gtetil/flame-detect-pcb/flame-detect-pcb.kicad_pcb

## KiCad design flame-detect-pcb.kicad_pcb (2018-03-28)

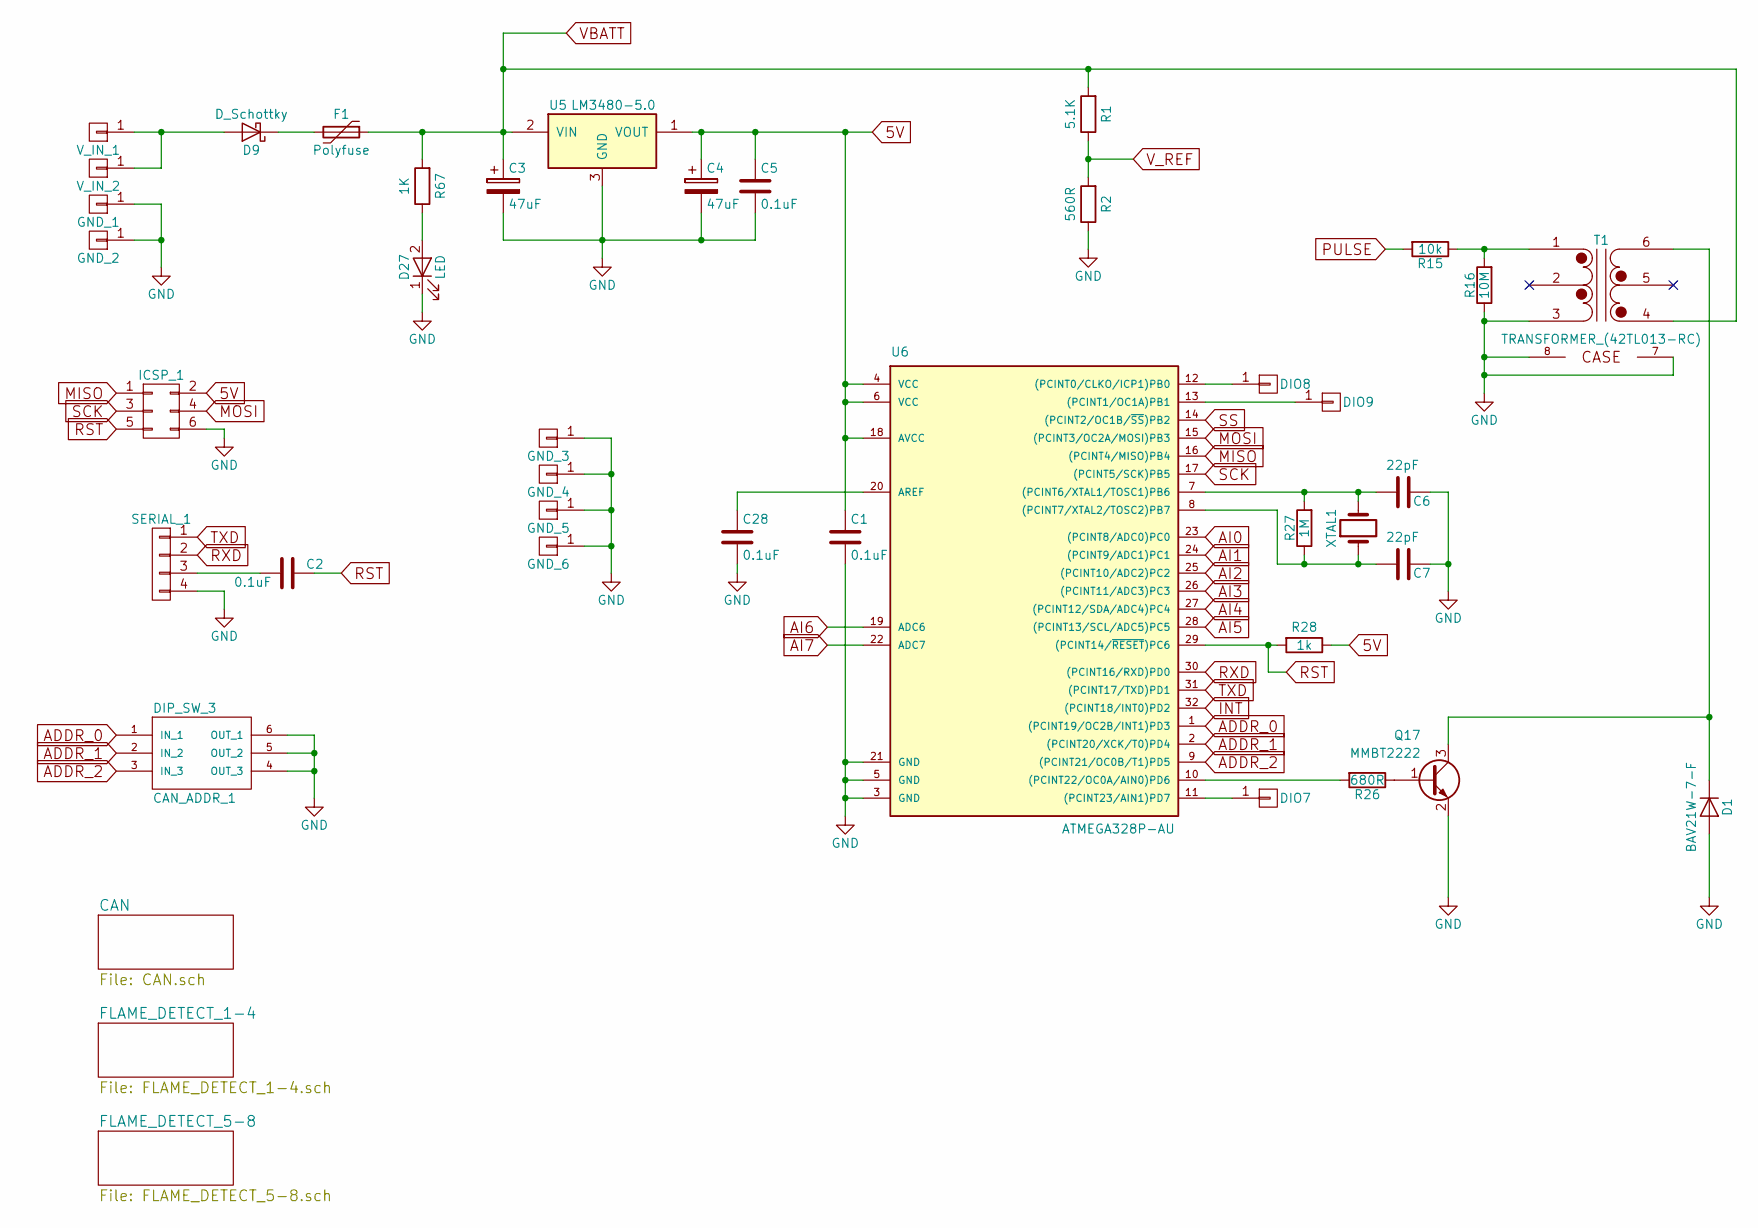
[picture p1: schematic flame-detect-pcb.sch]

Parts:
C1, C2, C5, C28: 0.1uF; C_0805
C3, C4: 47uF; CP_Elec_6.3x5.3
C6, C7: 22pF; C_0805
CAN_ADDR_1: DIP_SW_3; SW_DIP_x3_W8.61mm_Slide_LowProfile
D1: BAV21W-7-F; D_SOD-123
D9: D_Schottky; DO-214AB
D27: LED; LED_1206
DIO7, DIO8, DIO9: CONN_01X01; SPARE_THROUGH_HOLE
F1: Polyfuse; R_1812
GND_1, GND_2: CONN_01X01; KEYSTONE_SPADE_TERM_(1287)
GND_3, GND_4, GND_5, GND_6: CONN_01X01; PEM_STANDOFF_THRU_(SMTSOB-116-12ET)
ICSP_1: CONN_02X03; Pin_Header_Straight_2x03_Pitch2.54mm_SMD
Q17: MMBT2222; SOT-23
R1: 5.1K; R_0805
R2: 560R; R_0805
R15: 10k; R_0805
R16: 10M; R_0805
R26: 680R; R_0805
R27: 1M; R_0805
R28: 1k; R_0805
R67: 1K; R_0805
SERIAL_1: CONN_01X04; Pin_Header_Straight_1x04_Pitch2.54mm_SMD_Pin1Right
T1: TRANSFORMER_(42TL013-RC)
U5: LM3480-5.0; SOT-23
U6: ATMEGA328P-AU; TQFP-32_7x7mm_Pitch0.8mm
V_IN_1, V_IN_2: CONN_01X01; KEYSTONE_SPADE_TERM_(1287)
XTAL1: Crystal; Crystal_SMD_HC49-SD

Connections:
5V: C1.1, C4.1, C5.1, ICSP_1.2, R28.1, U5.1 (VOUT), U6.4 (VCC), U6.6 (VCC), U6.18 (AVCC); also elsewhere on the board
ADDR_0: CAN_ADDR_1.1 (IN_1), U6.1 ((PCINT19/OC2B/INT1)PD3)
ADDR_1: CAN_ADDR_1.2 (IN_2), U6.2 ((PCINT20/XCK/T0)PD4)
ADDR_2: CAN_ADDR_1.3 (IN_3), U6.9 ((PCINT21/OC0B/T1)PD5)
AI0: U6.23 ((PCINT8/ADC0)PC0); also elsewhere on the board
AI1: U6.24 ((PCINT9/ADC1)PC1); also elsewhere on the board
AI2: U6.25 ((PCINT10/ADC2)PC2); also elsewhere on the board
AI3: U6.26 ((PCINT11/ADC3)PC3); also elsewhere on the board
AI4: U6.27 ((PCINT12/SDA/ADC4)PC4); also elsewhere on the board
AI5: U6.28 ((PCINT13/SCL/ADC5)PC5); also elsewhere on the board
AI6: U6.19 (ADC6); also elsewhere on the board
AI7: U6.22 (ADC7); also elsewhere on the board
GND: C1.2, C3.2, C4.2, C5.2, C6.1, C7.1, C28.2, CAN_ADDR_1.4 (OUT_3), CAN_ADDR_1.5 (OUT_2), CAN_ADDR_1.6 (OUT_1), D1.2 (A), D27.1 (K), GND_1.1, GND_2.1, GND_3.1, GND_4.1, GND_5.1, GND_6.1, ICSP_1.6, Q17.2 (E), R2.1, R16.1, SERIAL_1.4, T1.3 (PR2), T1.7 (GND), T1.8 (GND), U5.3 (GND), U6.3 (GND), U6.5 (GND), U6.21 (GND); also elsewhere on the board
INT: U6.32 ((PCINT18/INT0)PD2); also elsewhere on the board
MISO: ICSP_1.1, U6.16 ((PCINT4/MISO)PB4); also elsewhere on the board
MOSI: ICSP_1.4, U6.15 ((PCINT3/OC2A/MOSI)PB3); also elsewhere on the board
unnamed: C2.2, SERIAL_1.3
unnamed: C6.2, R27.2, U6.7 ((PCINT6/XTAL1/TOSC1)PB6), XTAL1.2
unnamed: C7.2, R27.1, U6.8 ((PCINT7/XTAL2/TOSC2)PB7), XTAL1.1
unnamed: C28.1, U6.20 (AREF)
unnamed: D1.1 (K), Q17.3 (C), T1.6 (S3)
unnamed: D9.1 (K), F1.2
unnamed: D9.2 (A), V_IN_1.1, V_IN_2.1
unnamed: D27.2 (A), R67.1
unnamed: DIO7.1, U6.11 ((PCINT23/AIN1)PD7)
unnamed: DIO8.1, U6.12 ((PCINT0/CLKO/ICP1)PB0)
unnamed: DIO9.1, U6.13 ((PCINT1/OC1A)PB1)
unnamed: Q17.1 (B), R26.1
unnamed: R15.1, R16.2, T1.1 (PR1)
unnamed: R26.2, U6.10 ((PCINT22/OC0A/AIN0)PD6)
PULSE: R15.2; also elsewhere on the board
RST: C2.1, ICSP_1.5, R28.2, U6.29 ((PCINT14/~RESET~)PC6)
RXD: SERIAL_1.2, U6.30 ((PCINT16/RXD)PD0)
SCK: ICSP_1.3, U6.17 ((PCINT5/SCK)PB5); also elsewhere on the board
SS: U6.14 ((PCINT2/OC1B/~SS~)PB2); also elsewhere on the board
TXD: SERIAL_1.1, U6.31 ((PCINT17/TXD)PD1)
VBATT: C3.1, F1.1, R1.2, R67.2, T1.4 (S1), U5.2 (VIN); also elsewhere on the board
V_REF: R1.1, R2.2; also elsewhere on the board

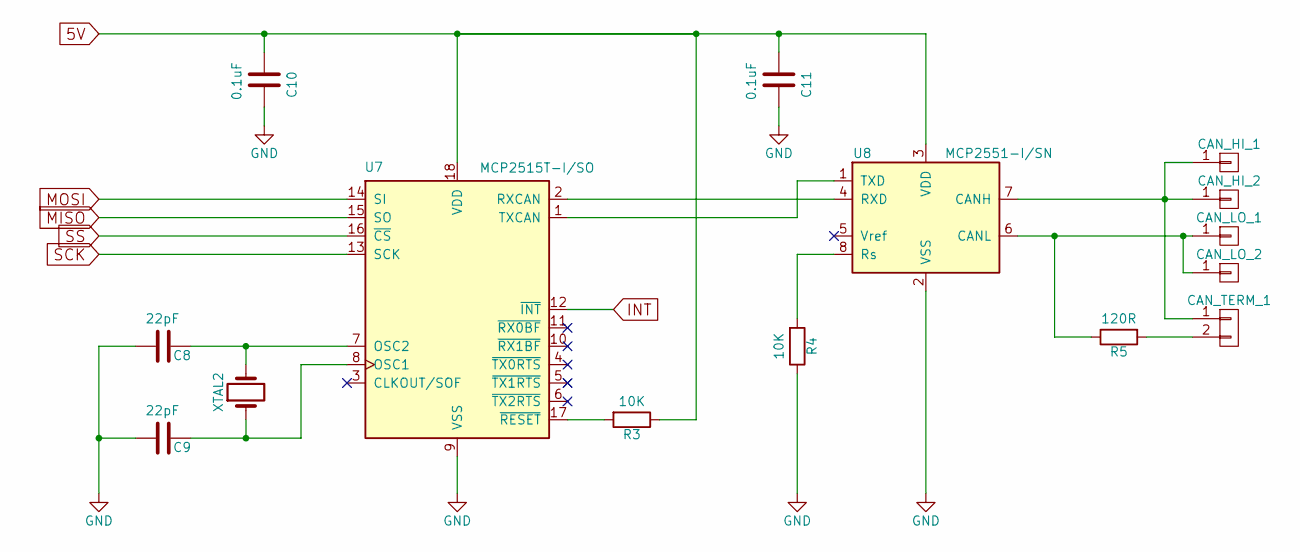
[picture p2: schematic CAN.sch]

Parts:
C8, C9: 22pF; C_0805
C10, C11: 0.1uF; C_0805
CAN_HI_1, CAN_HI_2: CONN_01X01; KEYSTONE_SPADE_TERM_(1287)
CAN_LO_1, CAN_LO_2: CONN_01X01; KEYSTONE_SPADE_TERM_(1287)
CAN_TERM_1: CONN_01X02; Pin_Header_Straight_1x02_Pitch2.54mm_SMD_Pin1Right
R3, R4: 10K; R_0805
R5: 120R; R_0805
U7: MCP2515T-I/SO; SOIC-18W_7.5x11.6mm_Pitch1.27mm
U8: MCP2551-I/SN; SOIC-8_3.9x4.9mm_Pitch1.27mm
XTAL2: Crystal; Crystal_SMD_HC49-SD

Connections:
5V: C10.2, C11.2, R3.1, U7.18 (VDD), U8.3 (VDD); also elsewhere on the board
GND: C8.2, C9.2, C10.1, C11.1, R4.1, U7.9 (VSS), U8.2 (VSS); also elsewhere on the board
INT: U7.12 (~INT); also elsewhere on the board
MISO: U7.15 (SO); also elsewhere on the board
MOSI: U7.14 (SI); also elsewhere on the board
unnamed: C8.1, U7.7 (OSC2), XTAL2.2
unnamed: C9.1, U7.8 (OSC1), XTAL2.1
unnamed: CAN_HI_1.1, CAN_HI_2.1, CAN_TERM_1.1, U8.7 (CANH)
unnamed: CAN_LO_1.1, CAN_LO_2.1, R5.1, U8.6 (CANL)
unnamed: CAN_TERM_1.2, R5.2
unnamed: R3.2, U7.17 (~RESET)
unnamed: R4.2, U8.8 (Rs)
unnamed: U7.1 (TXCAN), U8.1 (TXD)
unnamed: U7.2 (RXCAN), U8.4 (RXD)
SCK: U7.13 (SCK); also elsewhere on the board
SS: U7.16 (~CS); also elsewhere on the board

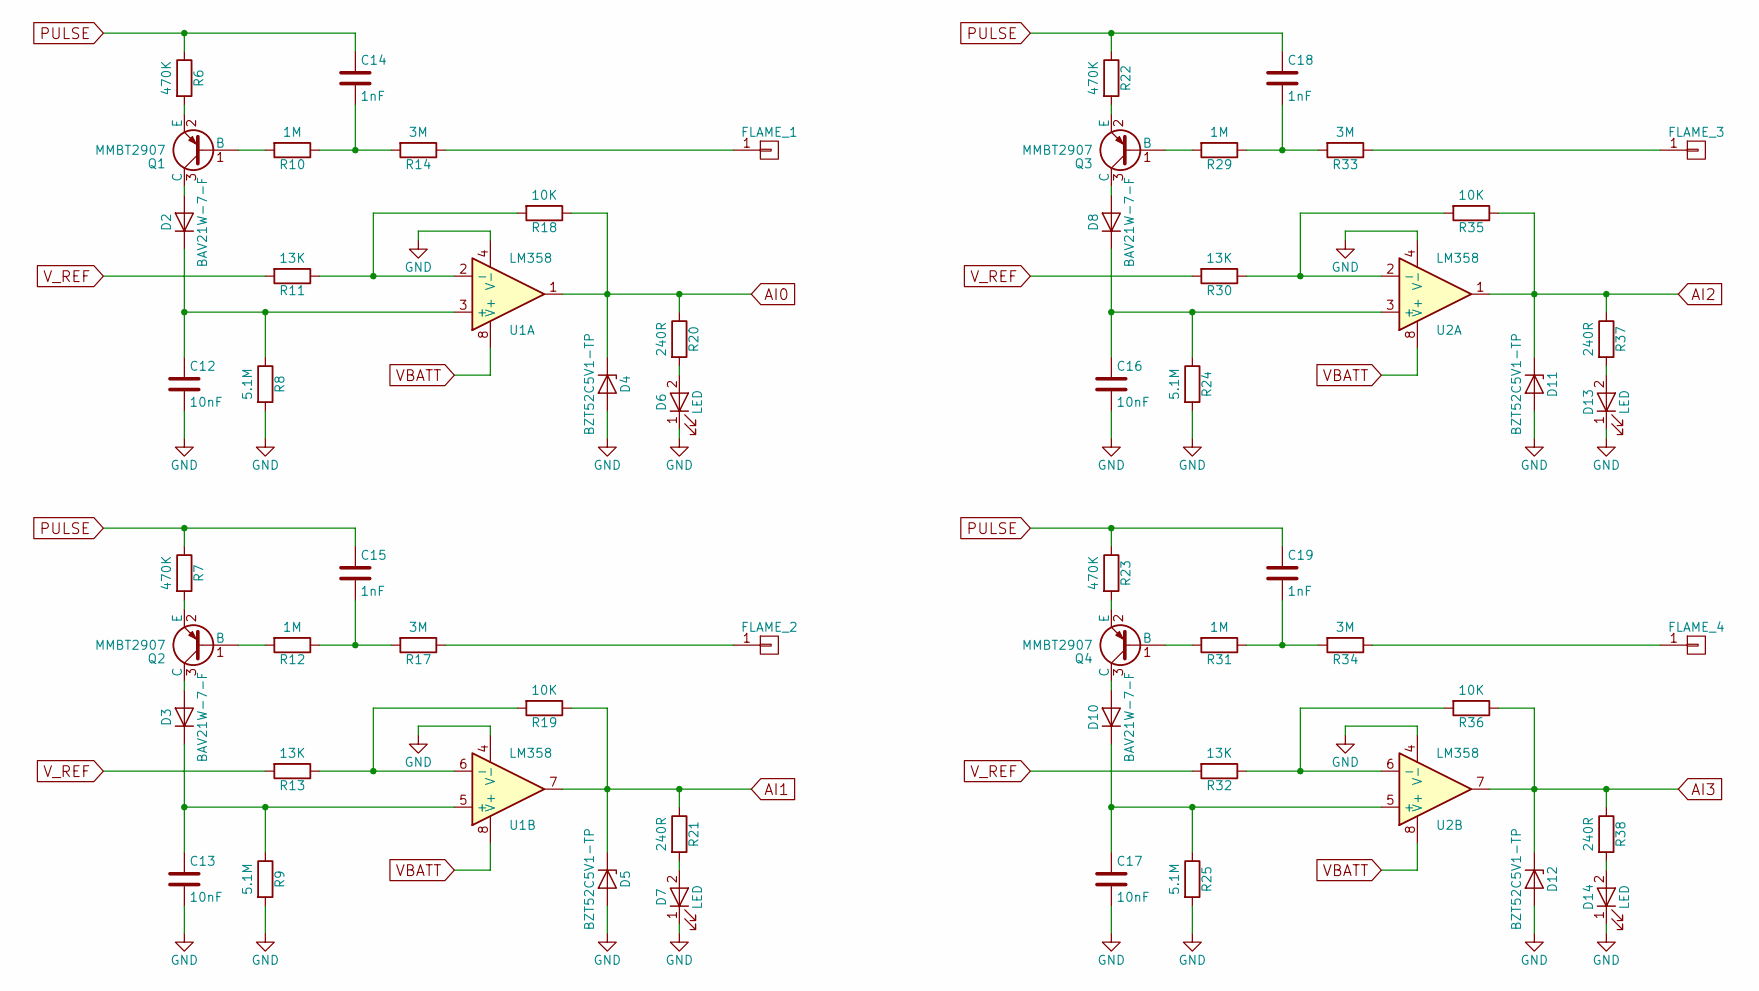
[picture p3: schematic FLAME_DETECT_1-4.sch]

Parts:
C12, C13, C16, C17: 10nF; C_0805
C14, C15, C18, C19: 1nF; C_0805
D2, D3, D8, D10: BAV21W-7-F; D_SOD-123
D4, D5, D11, D12: BZT52C5V1-TP; D_SOD-123
D6, D7, D13, D14: LED; LED_1206
FLAME_1, FLAME_2, FLAME_3, FLAME_4: CONN_01X01; KEYSTONE_SPADE_TERM_(1287)
Q1, Q2, Q3, Q4: MMBT2907; SOT-23
R6, R7, R22, R23: 470K; R_0805
R8, R9, R24, R25: 5.1M; R_0805
R10, R12, R29, R31: 1M; R_0805
R11, R13, R30, R32: 13K; R_0805
R14, R17, R33, R34: 3M; R_0805
R18, R19, R35, R36: 10K; R_0805
R20, R21, R37, R38: 240R; R_0805
U1, U2: LM358; SOIC-8_3.9x4.9mm_Pitch1.27mm

Connections:
AI0: D4.1 (K), R18.1, R20.1, U1.1; also elsewhere on the board
AI1: D5.1 (K), R19.1, R21.1, U1.7; also elsewhere on the board
AI2: D11.1 (K), R35.1, R37.1, U2.1; also elsewhere on the board
AI3: D12.1 (K), R36.1, R38.1, U2.7; also elsewhere on the board
GND: C12.2, C13.2, C16.2, C17.2, D4.2 (A), D5.2 (A), D6.1 (K), D7.1 (K), D11.2 (A), D12.2 (A), D13.1 (K), D14.1 (K), R8.2, R9.2, R24.2, R25.2, U1.4 (V-), U2.4 (V-); also elsewhere on the board
unnamed: C12.1, D2.1 (K), R8.1, U1.3 (+)
unnamed: C13.1, D3.1 (K), R9.1, U1.5 (+)
unnamed: C14.2, R10.1, R14.2
unnamed: C15.2, R12.1, R17.2
unnamed: C16.1, D8.1 (K), R24.1, U2.3 (+)
unnamed: C17.1, D10.1 (K), R25.1, U2.5 (+)
unnamed: C18.2, R29.1, R33.2
unnamed: C19.2, R31.1, R34.2
unnamed: D2.2 (A), Q1.3 (C)
unnamed: D3.2 (A), Q2.3 (C)
unnamed: D6.2 (A), R20.2
unnamed: D7.2 (A), R21.2
unnamed: D8.2 (A), Q3.3 (C)
unnamed: D10.2 (A), Q4.3 (C)
unnamed: D13.2 (A), R37.2
unnamed: D14.2 (A), R38.2
unnamed: FLAME_1.1, R14.1
unnamed: FLAME_2.1, R17.1
unnamed: FLAME_3.1, R33.1
unnamed: FLAME_4.1, R34.1
unnamed: Q1.1 (B), R10.2
unnamed: Q1.2 (E), R6.2
unnamed: Q2.1 (B), R12.2
unnamed: Q2.2 (E), R7.2
unnamed: Q3.1 (B), R29.2
unnamed: Q3.2 (E), R22.2
unnamed: Q4.1 (B), R31.2
unnamed: Q4.2 (E), R23.2
unnamed: R11.1, R18.2, U1.2 (-)
unnamed: R13.1, R19.2, U1.6 (-)
unnamed: R30.1, R35.2, U2.2 (-)
unnamed: R32.1, R36.2, U2.6 (-)
PULSE: C14.1, C15.1, C18.1, C19.1, R6.1, R7.1, R22.1, R23.1; also elsewhere on the board
VBATT: U1.8 (V+), U2.8 (V+); also elsewhere on the board
V_REF: R11.2, R13.2, R30.2, R32.2; also elsewhere on the board

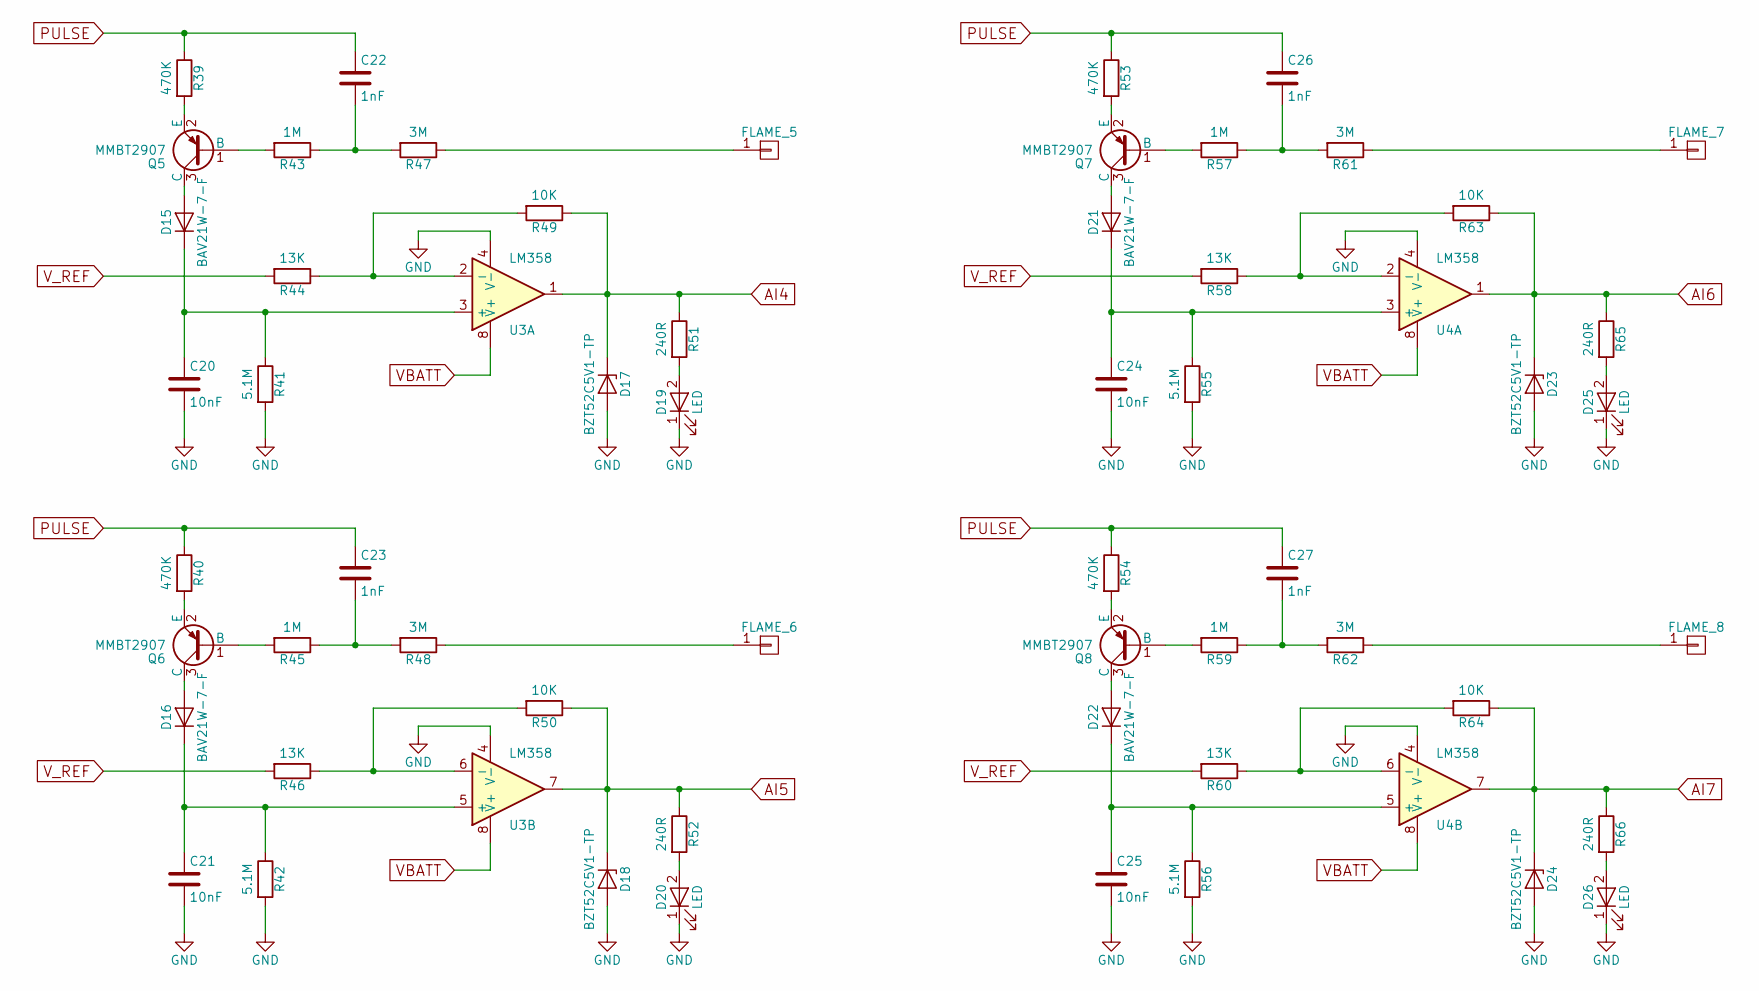
[picture p4: schematic FLAME_DETECT_5-8.sch]

Parts:
C20, C21, C24, C25: 10nF; C_0805
C22, C23, C26, C27: 1nF; C_0805
D15, D16, D21, D22: BAV21W-7-F; D_SOD-123
D17, D18, D23, D24: BZT52C5V1-TP; D_SOD-123
D19, D20, D25, D26: LED; LED_1206
FLAME_5, FLAME_6, FLAME_7, FLAME_8: CONN_01X01; KEYSTONE_SPADE_TERM_(1287)
Q5, Q6, Q7, Q8: MMBT2907; SOT-23
R39, R40, R53, R54: 470K; R_0805
R41, R42, R55, R56: 5.1M; R_0805
R43, R45, R57, R59: 1M; R_0805
R44, R46, R58, R60: 13K; R_0805
R47, R48, R61, R62: 3M; R_0805
R49, R50, R63, R64: 10K; R_0805
R51, R52, R65, R66: 240R; R_0805
U3, U4: LM358; SOIC-8_3.9x4.9mm_Pitch1.27mm

Connections:
AI4: D17.1 (K), R49.1, R51.1, U3.1; also elsewhere on the board
AI5: D18.1 (K), R50.1, R52.1, U3.7; also elsewhere on the board
AI6: D23.1 (K), R63.1, R65.1, U4.1; also elsewhere on the board
AI7: D24.1 (K), R64.1, R66.1, U4.7; also elsewhere on the board
GND: C20.2, C21.2, C24.2, C25.2, D17.2 (A), D18.2 (A), D19.1 (K), D20.1 (K), D23.2 (A), D24.2 (A), D25.1 (K), D26.1 (K), R41.2, R42.2, R55.2, R56.2, U3.4 (V-), U4.4 (V-); also elsewhere on the board
unnamed: C20.1, D15.1 (K), R41.1, U3.3 (+)
unnamed: C21.1, D16.1 (K), R42.1, U3.5 (+)
unnamed: C22.2, R43.1, R47.2
unnamed: C23.2, R45.1, R48.2
unnamed: C24.1, D21.1 (K), R55.1, U4.3 (+)
unnamed: C25.1, D22.1 (K), R56.1, U4.5 (+)
unnamed: C26.2, R57.1, R61.2
unnamed: C27.2, R59.1, R62.2
unnamed: D15.2 (A), Q5.3 (C)
unnamed: D16.2 (A), Q6.3 (C)
unnamed: D19.2 (A), R51.2
unnamed: D20.2 (A), R52.2
unnamed: D21.2 (A), Q7.3 (C)
unnamed: D22.2 (A), Q8.3 (C)
unnamed: D25.2 (A), R65.2
unnamed: D26.2 (A), R66.2
unnamed: FLAME_5.1, R47.1
unnamed: FLAME_6.1, R48.1
unnamed: FLAME_7.1, R61.1
unnamed: FLAME_8.1, R62.1
unnamed: Q5.1 (B), R43.2
unnamed: Q5.2 (E), R39.2
unnamed: Q6.1 (B), R45.2
unnamed: Q6.2 (E), R40.2
unnamed: Q7.1 (B), R57.2
unnamed: Q7.2 (E), R53.2
unnamed: Q8.1 (B), R59.2
unnamed: Q8.2 (E), R54.2
unnamed: R44.1, R49.2, U3.2 (-)
unnamed: R46.1, R50.2, U3.6 (-)
unnamed: R58.1, R63.2, U4.2 (-)
unnamed: R60.1, R64.2, U4.6 (-)
PULSE: C22.1, C23.1, C26.1, C27.1, R39.1, R40.1, R53.1, R54.1; also elsewhere on the board
VBATT: U3.8 (V+), U4.8 (V+); also elsewhere on the board
V_REF: R44.2, R46.2, R58.2, R60.2; also elsewhere on the board

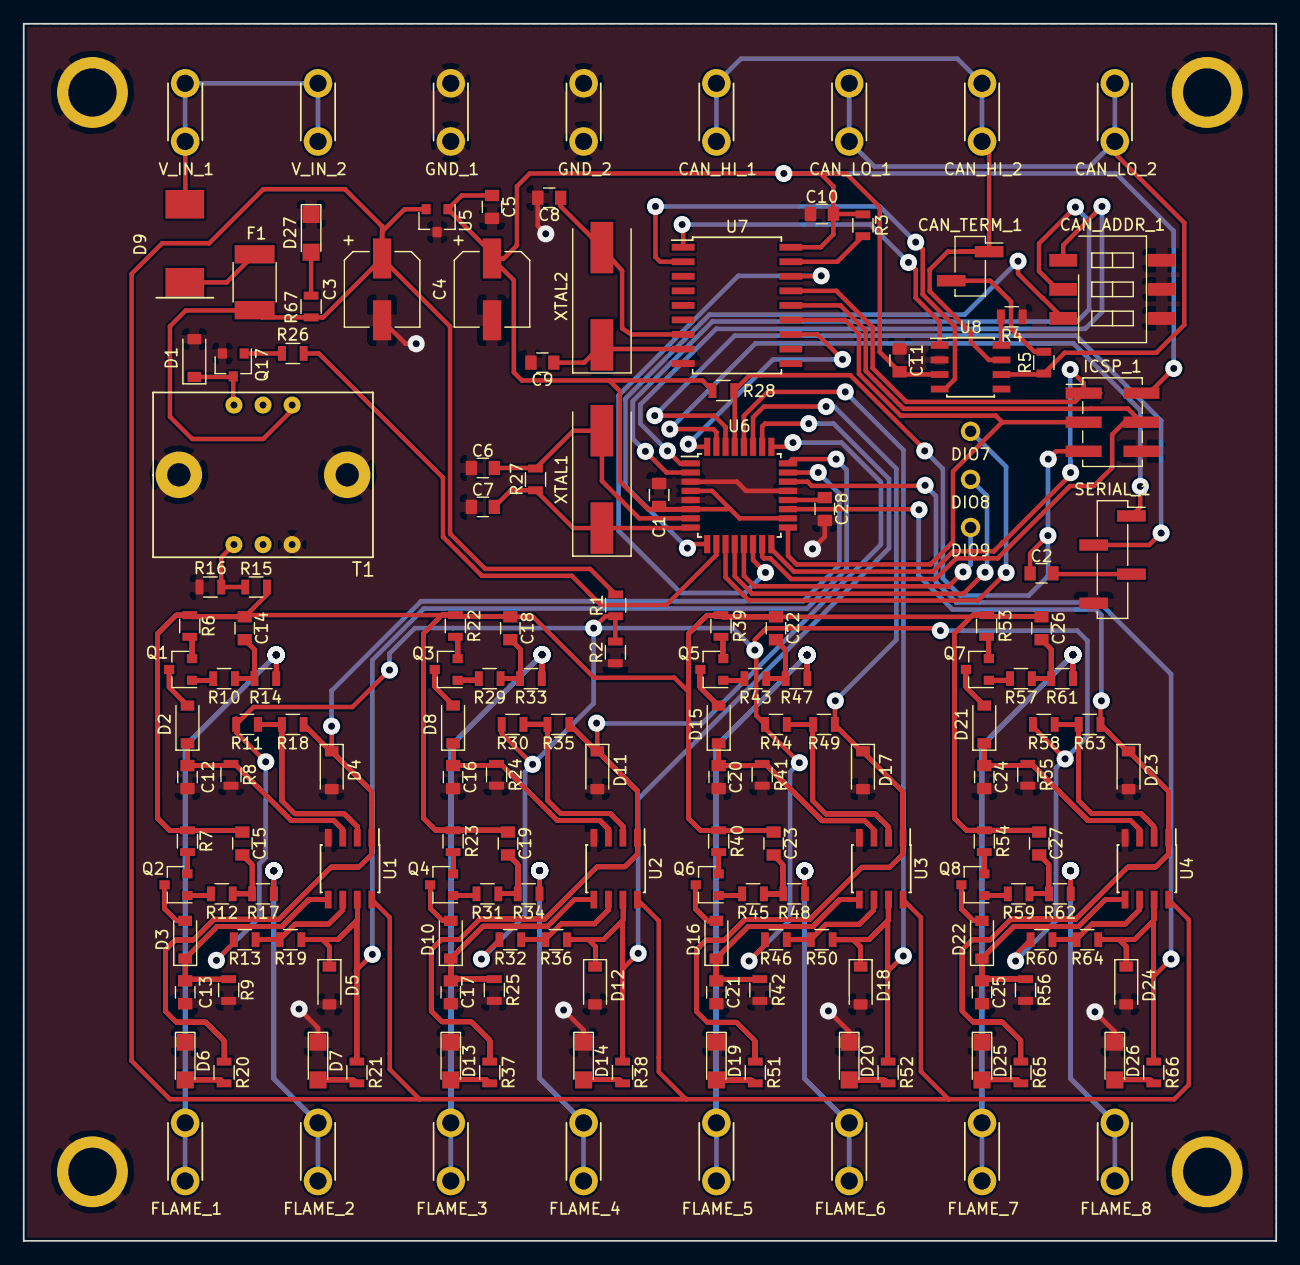
[picture p5: board flame-detect-pcb.kicad_pcb from above]

Board: 2 copper layers, 109.4 x 106.3 mm, 170 parts (0 on the bottom side), 111 nets.
