gtetil/flame-detect-pcb/(commit log)

2017-10-29 - Initial commit.
    [flame-detect-pcb.kicad_pcb, flame-detect-pcb.sch]
2017-10-29 - Created transformer block and footprint.
    [flame-detect-pcb.kicad_pcb]
2017-10-30 - Created circuits and footprints.
    [flame-detect-pcb.sch]
2017-10-31 - Finished board layout.
    [flame-detect-pcb.kicad_pcb]
2017-11-01 - Created gerbers, cam, and lmd files.
    [flame-detect-pcb-B.Cu.gbr, flame-detect-pcb-Edge.Cuts.gbr, flame-detect-pcb-F.Cu.gbr, flame-detect-pcb.drl]
2017-11-01 - Recreated. Was missing drill file.
2018-03-19 - Finished circuit for new 8 channel version. Ready to start on PCB.
    [CAN.sch, FLAME_DETECT.sch, FLAME_DETECT_1-4.sch, FLAME_DETECT_5-8.sch, flame-detect-pcb.sch, flame-detect-pcb_bom_.csv]
2018-03-19 - Finished footprints.
    [CAN.sch, FLAME_DETECT_1-4.sch, FLAME_DETECT_5-8.sch, flame-detect-pcb.kicad_pcb, flame-detect-pcb.sch]
2018-03-20 - Finished PCB layout.
    [CAN.sch, FLAME_DETECT_1-4.sch, FLAME_DETECT_5-8.sch, flame-detect-pcb.kicad_pcb, flame-detect-pcb.sch]
2018-03-21 - Fixed a couple layout issues, then created gerbers.
    [flame-detect-pcb.kicad_pcb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]
2018-03-28 - Fixed several bugs.
    [CAN.sch, FLAME_DETECT_1-4.sch, FLAME_DETECT_5-8.sch, flame-detect-pcb.kicad_pcb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]
2018-04-04 - Changed transformer transistor resistor to 10kohm.
    [flame-detect-pcb.sch]
